tonitchek/ltm-ps/README.md

ltm-ps
======
Power Supply board based on Linear Technology uModule (LTM).

Contents
========
circuit_board :containing the design of the PCB.
simu          :simulation of the design based on LTSpiceIV
