tonitchek/ltm-ps/circuit_board/bom_ltm-ps.ods

Id | Designator | Package | Quantity | Designation | Supplier | Ref | Price | Board price | Comments
1 | U2 | BGA70-linear_standard | 1 | LTM8050 | RS | 851-4598 (http://fr.rs-online.com/web/p/convertisseurs-buck/8514598/) | 27.29 | 27.29
 | J2 | RJ45_8N | 1 | RJHSE-5080 | FARNELL | 1860577 (http://fr.farnell.com/amphenol-commercial-products/rjhse-5080/fiche-rj45-1port/dp/1860577) | 0.61 | 0.61 |  | Ok
3 | J1 | RJ45_GIGABIT-MAGJACK | 1 | 0826-1X1T-M1-F | DIGIKEY | 380-1122-ND (http://www.digikey.fr/product-detail/fr/0826-1X1T-M1-F/380-1122-ND/1635090) | 4.65 | 4.65 |  | Ok
4 | D3,D2 | SDIP04 | 2 | DF01S | RS | 670-8804 (http://fr.rs-online.com/web/p/ponts-redresseurs/6708804/) | 0.335 | 0.67
5 | C1 | C_2220 | 1 | 4.7u | FARNELL | 2435503 (http://fr.farnell.com/tdk/cga9n2x7r2a475k230ka/condensateur-mlcc-x7r-4-7uf-100v/dp/2435503) | 1.94 | 1.94 |  | Ok
6 | C2 | C_1210 | 1 | 100u | FARNELL | 1108328 (http://fr.farnell.com/kemet/c1210c107m9pactu/condensateur-mlcc-x5r-100uf-6/dp/1108328) | 0.915 | 0.915 |  | Ok
7 | C3 | C_0805 | 1 | 1000p | FARNELL | 1855318 (http://fr.farnell.com/kemet/c0805x102kdractu/condensateur-mlcc-x7r-1nf-1kv/dp/1855318) | 0.322 | 0.322 |  | Ok
8 | D1 | Diode-SMC_Standard | 1 | S5BC-13-F | FARNELL | 1858674 (http://fr.farnell.com/diodes-inc/s5bc-13-f/diode-de-redressement-gpp-100v/dp/1858674) | 0.614 | 0.614 |  | Ok
9 | D4 | Diode-SMA_Standard | 1 | SMAJ58CA | FARNELL | 1749359 (http://fr.farnell.com/stmicroelectronics/smaj58ca-tr/transil-400w-58v-bidirect-sma/dp/1749359) | 0.302 | 0.302 |  | Ok
10 | JP1 | Pin_Header_Straight_1x03 | 1 | JUMPER3 | FARNELL | 1022255 (http://fr.farnell.com/harwin/m20-9990646/embase-1-rangee-6-voies/dp/1022255) | 0.138 | 0.138 |  | Ok
11 | P1,P2,P3 | Pin_Header_Straight_1x02 | 3 | CONN_01X02 |  |  |  | 0 |  | Ok
12 | R1 | R_0805 | 1 | 93.1k | RS | 708-6720 (http://fr.rs-online.com/web/p/resistances-cms/7086720/) | 0.028 | 0.028
13 | R2 | R_0805 | 1 | 90.9k | FARNELL | 2141897 (http://fr.farnell.com/multicomp/mc01w0805190k9/resistance-90k9-0-1w-1-0805/dp/2141897) | 0.045 | 0.045 |  | Ok
14 | R3 | R_0805 | 1 | 24.9k | FARNELL | 2141867 (http://fr.farnell.com/multicomp/mc01w0805124k9/resistance-24k9-0-1w-1-0805/dp/2141867) | 0.043 | 0.043 |  | Ok
15 | R4 | R_0805 | 1 | 4.42k | FARNELL | 2141825 (http://fr.farnell.com/multicomp/mc01w080514k42/resistance-4k42-0-1w-1-0805/dp/2141825) | 0.045 | 0.045 |  | Ok
16 | R5 | R_0805 | 1 | 178k | FARNELL | 2141911 (http://fr.farnell.com/multicomp/mc01w08051178k/resistance-178k-0-1w-1-0805/dp/2141911) | 0.042 | 0.042 |  | Ok
17 | R6 | R_0805 | 1 | 150k | FARNELL | 2332100 (http://fr.farnell.com/te-connectivity/crgh0805f150k/resistance-puissance-150k-0-33w/dp/2332100) | 0.0236 | 0.0236 |  | Ok
18 | R7 | R_0805 | 1 | 100k | FARNELL | 2333538 (http://fr.farnell.com/bourns/cr0805-fx-1003elf/resistance-couche-epaisse-100k/dp/2333538) | 0.0426 | 0.0426 |  | Ok
19 | R8,R9,R10,R11 | R_0805 | 4 | 75R | FARNELL | 2332056 (http://fr.farnell.com/te-connectivity/crgh0805f75r/resistance-puissance-75r-0-33w/dp/2332056) | 0.0229 | 0.0916 |  | Ok
20 | U1 | SOIC-8-N | 1 | NCP1092 | DIGIKEY | NCP1092DGOS-ND (http://www.digikey.fr/product-detail/fr/NCP1092DG/NCP1092DGOS-ND/2442748) | 1.66 | 1.66 | Alternative to NCP1092: TI TPS2378 farnell 2144277 (http://fr.farnell.com/texas-instruments/tps2378dda/poe-ieee802-3at-type2-0-85a-8soic/dp/2144277)
 |  |  |  |  |  |  |  | 39.4718
