tonitchek/ltm-ps/circuit_board/manufacturing_outputs/ltm-ps.pdf

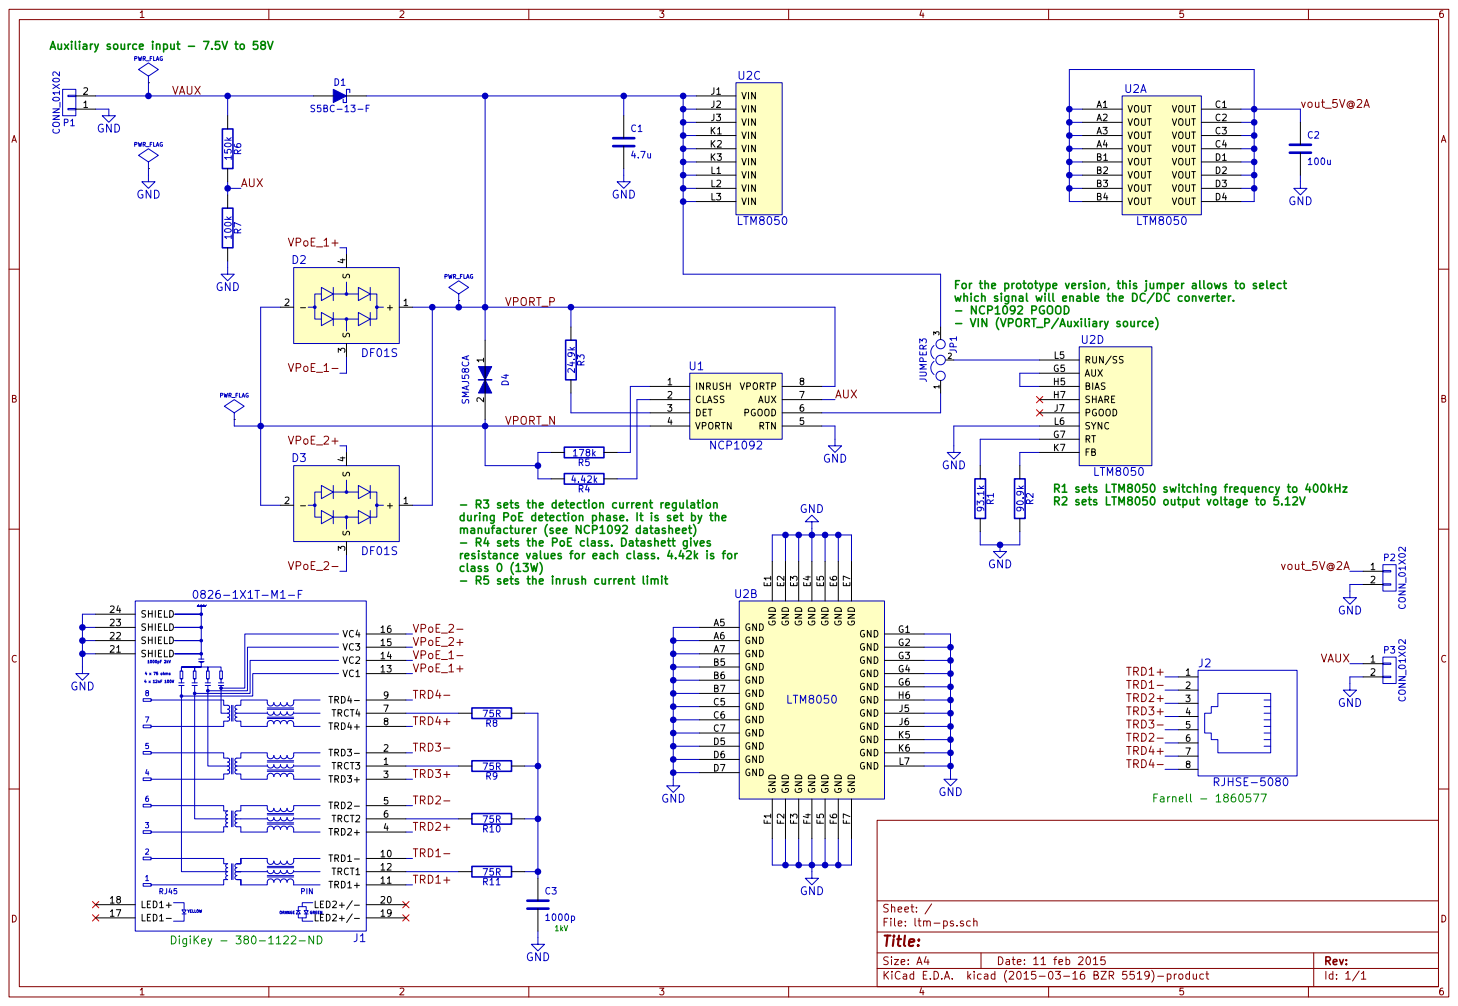
[picture p1: page 1]

PWR_FLAG Auxiliary source input - 7.5V to 58V

- R5 sets the inrush current limit VAUX

For the prototype version, this jumper allows to select
which signal will enable the DC/DC converter.
- NCP1092 PGOOD
- VIN (VPORT_P/Auxiliary source)

R1 sets LTM8050 switching frequency to 400kHz
R2 sets LTM8050 output voltage to 5.12V

- R3 sets the detection current regulation
during PoE detection phase. It is set by the
manufacturer (see NCP1092 datasheet)
- R4 sets the PoE class. Datashett gives
resistance values for each class. 4.42k is for class 0 (13W)

8 J2 RJHSE-5080 Farnell - 1860577 DigiKey - 380-1122-ND
