tonitchek/ltm-ps/simu/ltm8050-ps.asc

C1: cap; 100µ; V=6.3
C2: cap; 4.7µ; V=100
R1: res; 90.9k
R2: res; 2.5
R3: res; 93.1k
U1: LTM8050
V1: voltage; 48
Named nets: 0, VIN, VOUT
.tran 0.6m
