tonitchek/ltm-ps/simu/poe-to-vout.asc

C1: cap; 100µ; V=6.3
C2: cap; 4.7µ; V=100
D1: schottky; MBRS1100
D2: schottky; MBRS1100
D3: schottky; MBRS1100
D4: schottky; MBRS1100
R1: res; 2.5
R2: res; 89.4k
R3: res; 93.1k
U1: LTM8050
V1: voltage; SINE(0 48 1k)
Named nets: 0, Vpoe, Vout, VPORTN
.tran 1m
