tonitchek/ltm-ps/simu/auxiliary_source.asc

D1: schottky; PDS5100
R1: res; 150k
R2: res; 100k
Rload: res; 12
V1: voltage; 60
V2: voltage; 48
Named nets: 0, VPoE, VPORTP, VAUX, AUX
.tran 1m
