tonitchek/ltm-ps/simu/ltm4609-ps.asc

C1: cap; {Cb}; x{nb}; Rser={Rb} Lser={Lb} ppPkg={nb}
C2: cap; .002µ
C3: cap; {Cinb}; x{ninb}; Rser={Rinb} Lser={Linb} ppPkg={ninb}
C4: cap; {Cince}; x{nince}; Rser={Rince} Lser={Lince} ppPkg={nince}
C6: cap; {Cce}; x{nce}; Rser={Rce} Lser={Lce} ppPkg={nce}
L1: ind; {L}; Rser={DCR}
L2: ind; {Lin}; Rser={DCRin}
L3: ind; {Lout}; Rser={DCRo}
R1: res; {Rsense}
R2: res; {Rref}
R3: res; 100K
R5: res; 1.2Meg
R6: res; 4k
R7: res; 1k
U1: LTM4609
V1: voltage; {Vin}
Named nets: 0, IN, OUT, Vsw2, Vsw1
Parameters imported from LTPowerCAD Design Tool:
.tran 3.5m startup
If simulation model is not found, please "Sync Release".
.params Vin=36V Io=4A Rref=3.42K 
.params Cinb=150u Rinb=72m Linb=3.3n ninb=1 Lin=100p DCRin=0 
.params Cince=10u Rince=7m Lince=1.2n nince=1 L=4.7u DCR=7m 
.params Cb=150u Rb=35m Lb=3n nb=2 Lout=100p DCRo=0 
.params Cce=10u Rce=5m Lce=1.5n nce=2 Rsense=7.5m
