tonitchek/ltm-ps/circuit_board/ltm-ps.kicad_pcb

## KiCad design circuit_board/ltm-ps.kicad_pcb (2015-03-23)

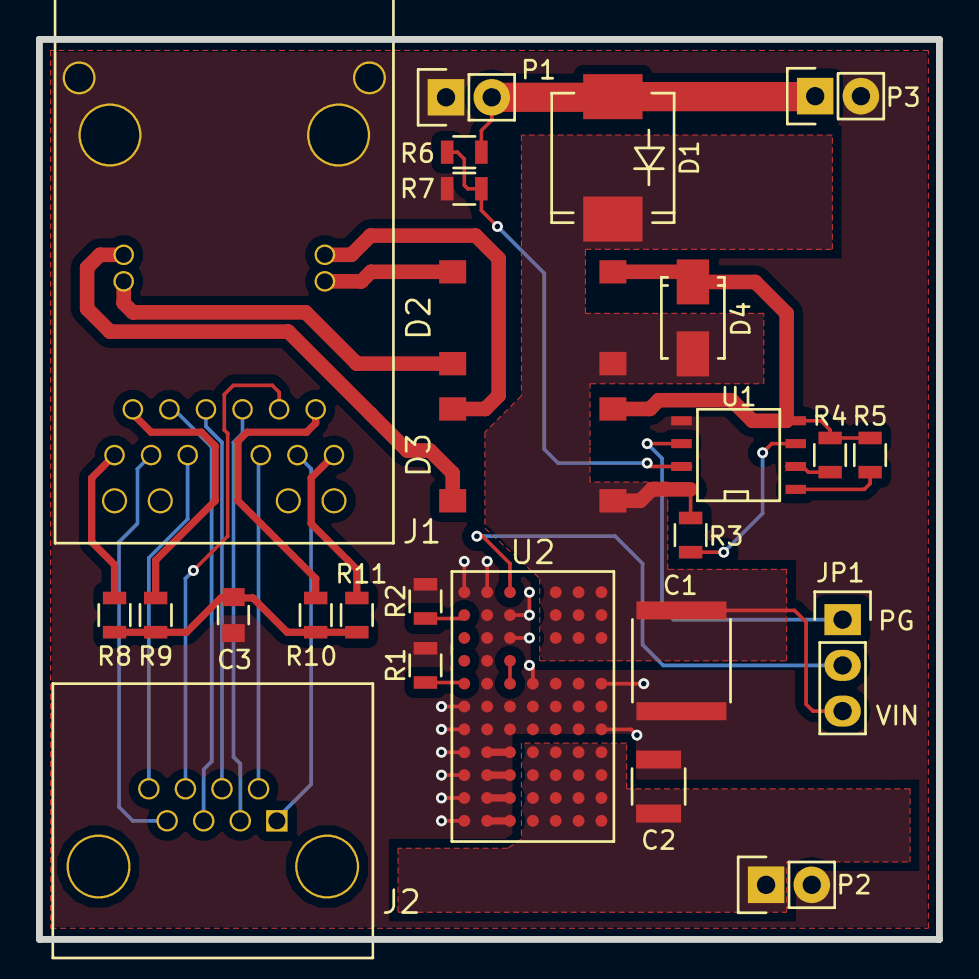
[picture p2: board ltm-ps.kicad_pcb from above]

Board: 2 copper layers, 50.0 x 50.0 mm, 26 parts (0 on the bottom side), 31 nets.

Parts:
C1: 4.7u; C_2220
C2: 100u; C_1210
C3: 1000p; C_0805
D1: S5BC-13-F; Diode-SMC_Standard
D2, D3: DF01S; SDIP04
D4: SMAJ58CA; Diode-SMA_Standard
J1: 0826-1X1T-M1-F; RJ45_GIGABIT-MAGJACK
J2: RJHSE-5080; RJ45_8N
JP1: JUMPER3; Pin_Header_Straight_1x03
P1, P2, P3: CONN_01X02; Pin_Header_Straight_1x02
R1: 93.1k; R_0805
R2: 90.9k; R_0805
R3: 24.9k; R_0805
R4: 4.42k; R_0805
R5: 178k; R_0805
R6: 150k; R_0805
R7: 100k; R_0805
R8, R9, R10, R11: 75R; R_0805
U1: NCP1092; SOIC-8-N
U2: LTM8050; BGA70-linear_standard

Connections:
/AUX: R6.2, R7.1, U1.7
/TRD1+: J1.11, J2.1
/TRD1-: J1.10, J2.2
/TRD2+: J1.4, J2.3
/TRD2-: J1.5, J2.6
/TRD3+: J1.3, J2.4
/TRD3-: J1.2, J2.5
/TRD4+: J1.8, J2.7
/TRD4-: J1.9, J2.8
/VAUX: D1.1, P1.2, P3.1, R6.1
/VPORT_N: D2.2, D3.2, D4.2, R4.2, R5.2, U1.4
/VPORT_P: C1.1, D1.2, D2.1, D3.1, D4.1, JP1.3, R3.1, U1.8, U2.J1, U2.J2, U2.J3, U2.K1, U2.K2, U2.K3, U2.L1, U2.L2, U2.L3
/VPoE_1+: D2.4, J1.13
/VPoE_1-: D2.3, J1.14
/VPoE_2+: D3.4, J1.15
/VPoE_2-: D3.3, J1.16
/vout_5V@2A: C2.1, P2.1, U2.A1, U2.A2, U2.A3, U2.A4, U2.B1, U2.B2, U2.B3, U2.B4, U2.C1, U2.C2, U2.C3, U2.C4, U2.D1, U2.D2, U2.D3, U2.D4
GND: C1.2, C2.2, C3.2, J1.21, J1.22, J1.23, J1.24, P1.1, P2.2, P3.2, R1.2, R2.2, R7.2, U1.5, U2.A5, U2.A6, U2.A7, U2.B5, U2.B6, U2.B7, U2.C5, U2.C6, U2.C7, U2.D5, U2.D6, U2.D7, U2.E1, U2.E2, U2.E3, U2.E4, U2.E5, U2.E6, U2.E7, U2.F1, U2.F2, U2.F3, U2.F4, U2.F5, U2.F6, U2.F7, U2.G1, U2.G2, U2.G3, U2.G4, U2.G6, U2.H6, U2.J5, U2.J6, U2.K5, U2.K6, U2.L6, U2.L7
unnamed: C3.1, R8.1, R9.1, R10.1, R11.1
unnamed: J1.1, R9.2
unnamed: J1.6, R10.2
unnamed: J1.7, R8.2
unnamed: J1.12, R11.2
unnamed: JP1.1, U1.6
unnamed: JP1.2, U2.L5
unnamed: R1.1, U2.G7
unnamed: R2.1, U2.K7
unnamed: R3.2, U1.3
unnamed: R4.1, U1.2
unnamed: R5.1, U1.1
unnamed: U2.G5, U2.H5
