tonitchek/ltm-ps/circuit_board/manufacturing_outputs/readme

=====================
Manufacturing outputs
=====================

These files are the GERBER outputs files generated by KiCAD.

ltmps        :contains links to the GERBER files with the names as asked by the
              manufacturer "seeedstudio"

zip-ltmps.sh :script zipping the folder ltmps for uploading in seeedstudio
              order process.
              Execute this script each time PCB is ploted from KiCAD.
