tonitchek/ltm-ps/simu/ltm4609-ps_simu-results.odt

LTM4609. Wide Input range (9-36V) with VOUT 24V @ 4A max

This document presents results of simulation on LTM4609. The following graphs shows the behavior of the component at 2 different load for each 3 different input voltage:

VIN=9V Iout=20uA

VIN=9V Iout=4A

VIN=12V Iout=20uA

VIN=12V Iout=4A

VIN=36V Iout=20uA

VIN=36V Iout=4A

Output voltage is always 24V.

Here is the schematic of the corresponding simulation around the LTM4609.

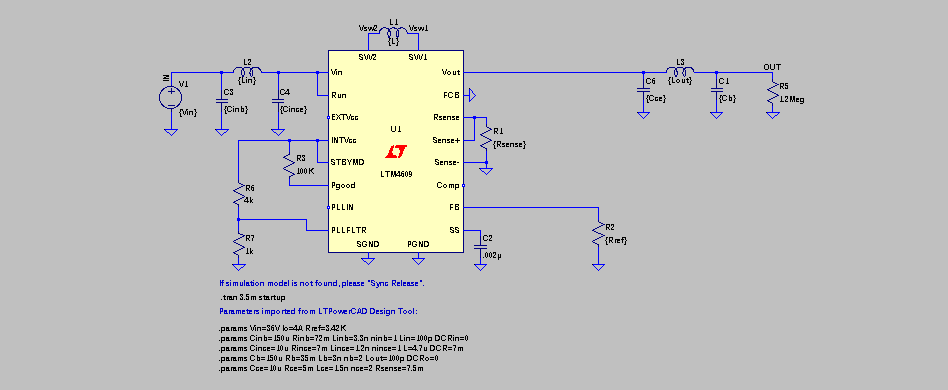
[picture p3: figure]

VIN=9V, VOUT=24V, IOUT=20uA

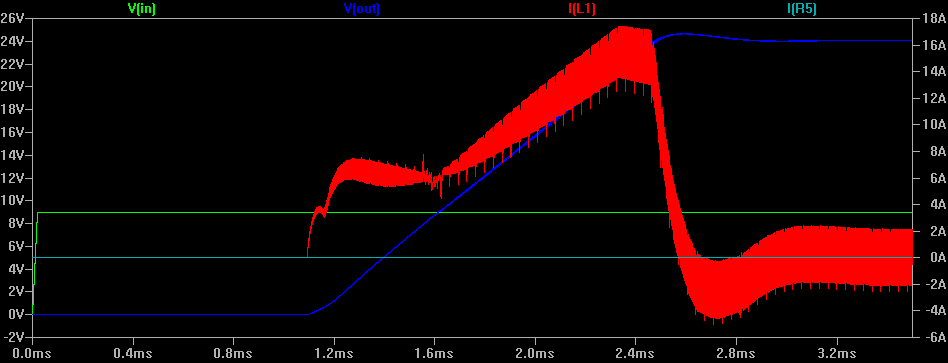
[picture p4: figure]
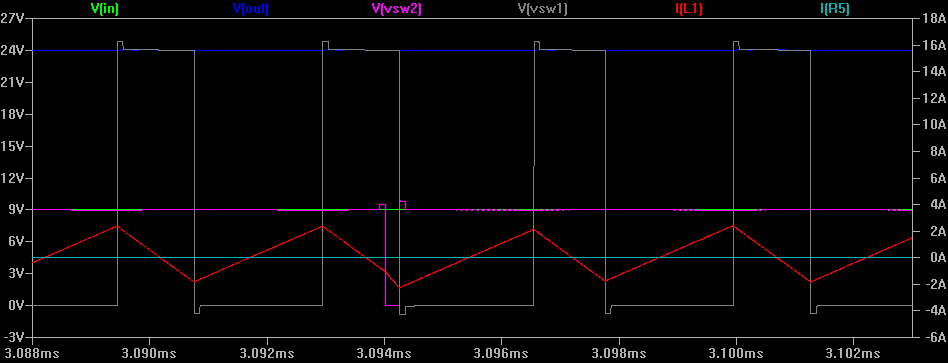
[picture p5: figure]
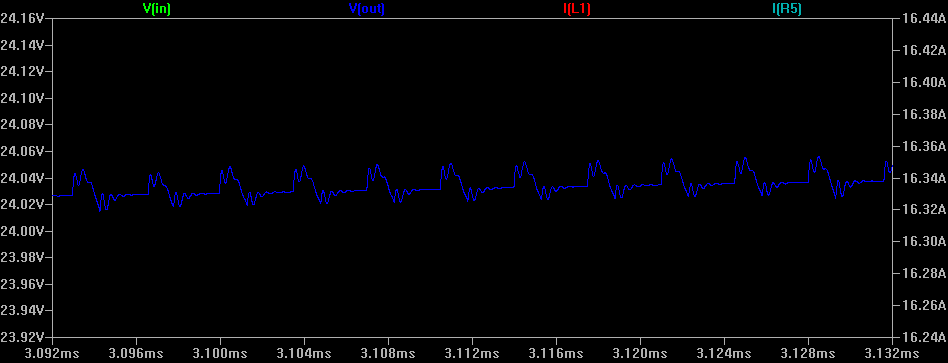
[picture p6: figure]

VIN=9V, VOUT=24V, IOUT=4A

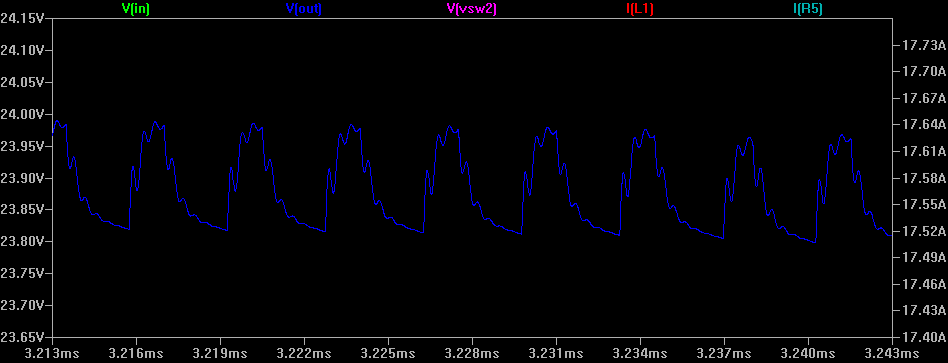
[picture p7: figure]
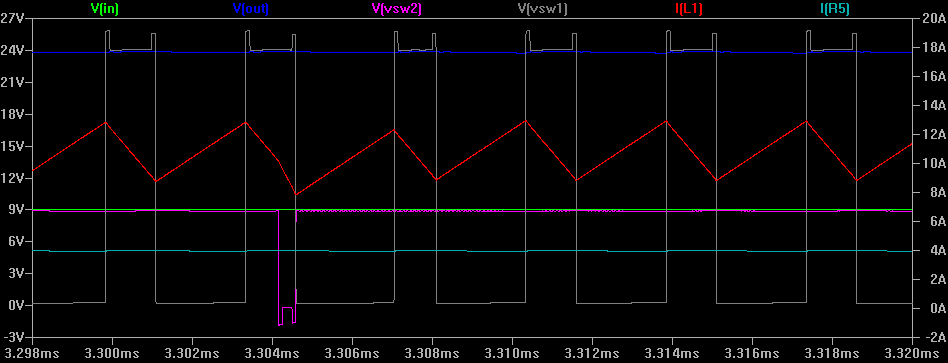
[picture p8: figure]
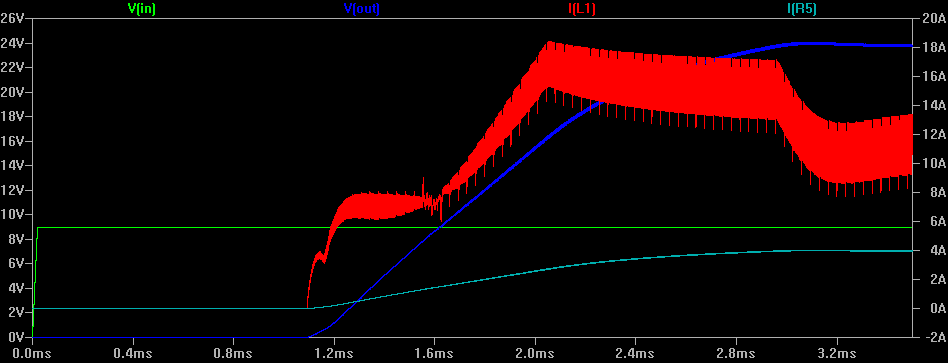
[picture p9: figure]

VIN=12V, VOUT=24V, IOUT=20uA

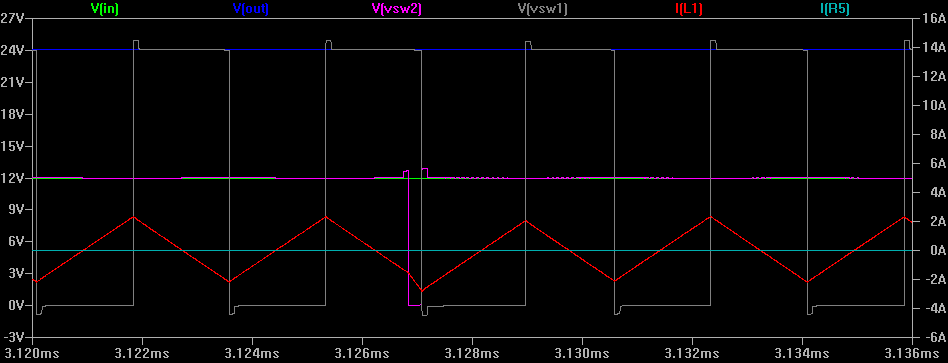
[picture p10: figure]
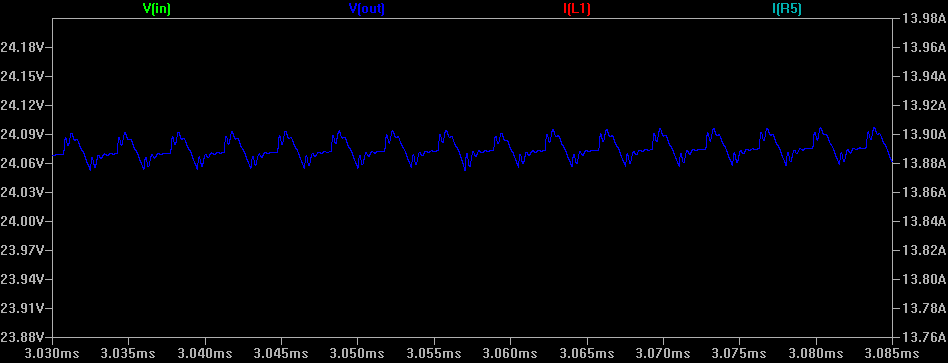
[picture p11: figure]
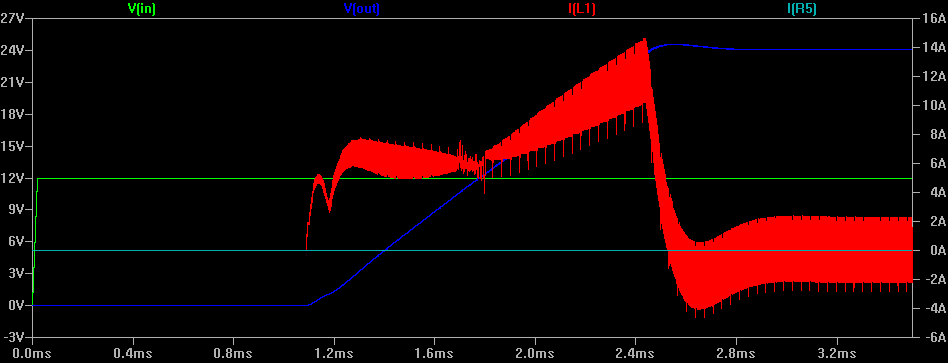
[picture p12: figure]

VIN=12V, VOUT=24V, IOUT=4A

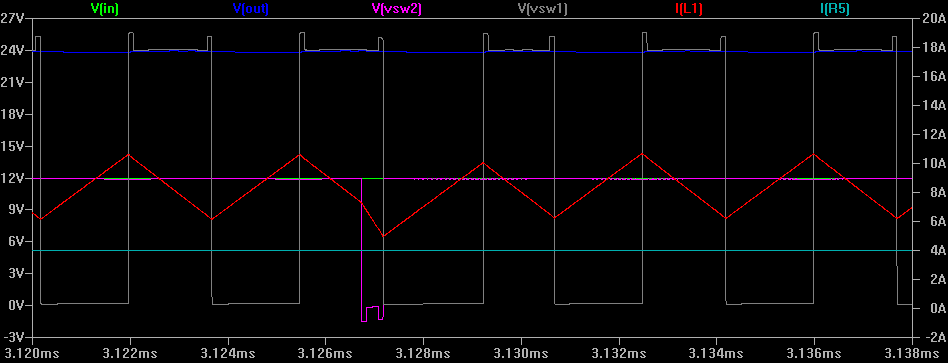
[picture p13: figure]
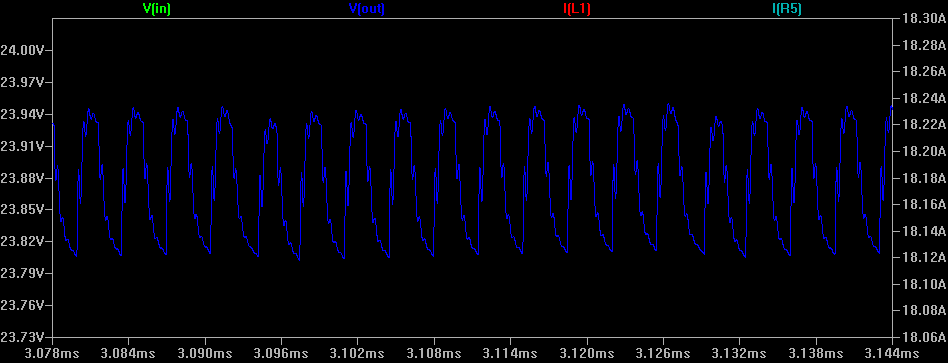
[picture p14: figure]
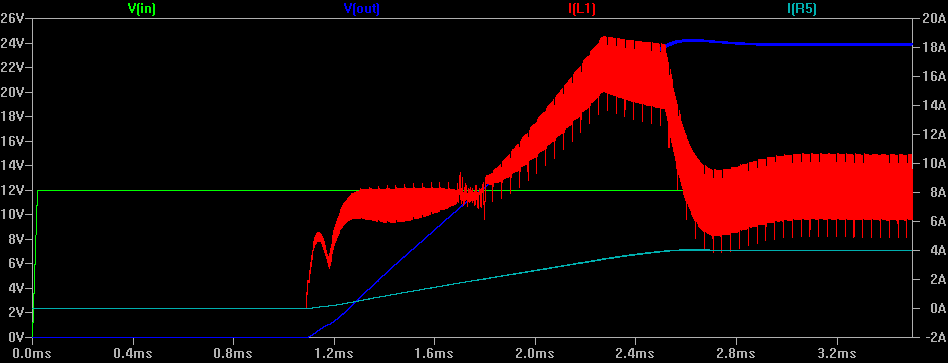
[picture p15: figure]

VIN=36V, VOUT=24V, IOUT=20uA

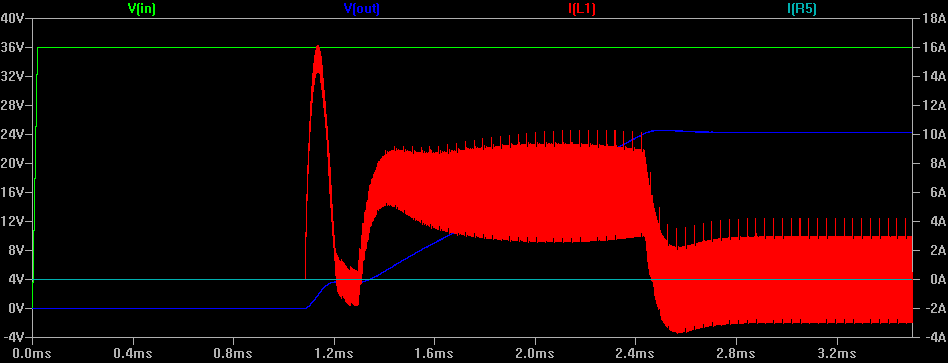
[picture p16: figure]
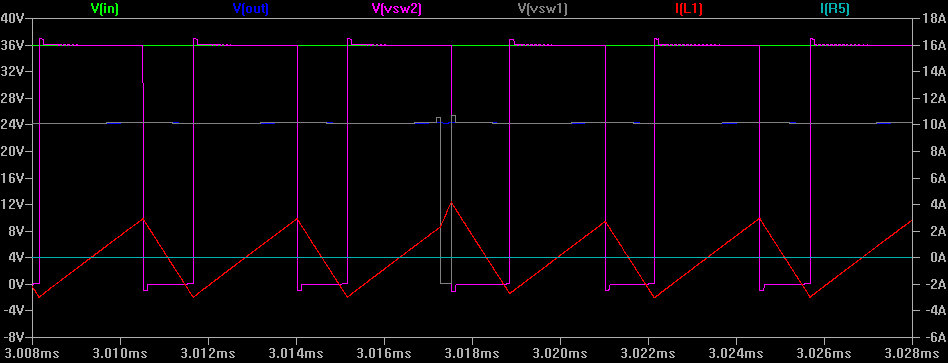
[picture p17: figure]
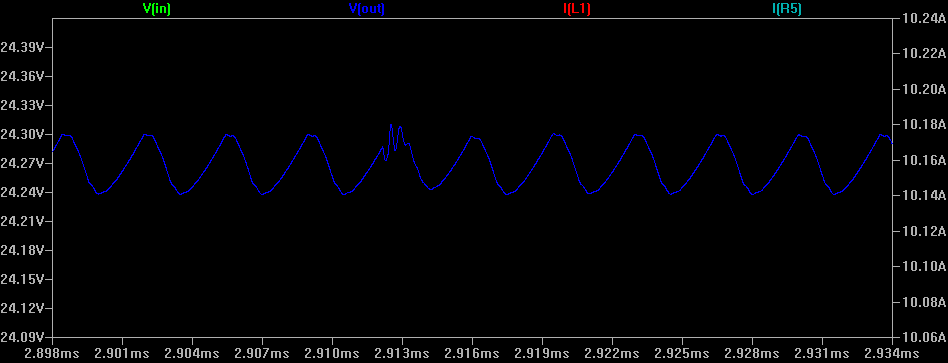
[picture p18: figure]

VIN=36V, VOUT=24V, IOUT=4A

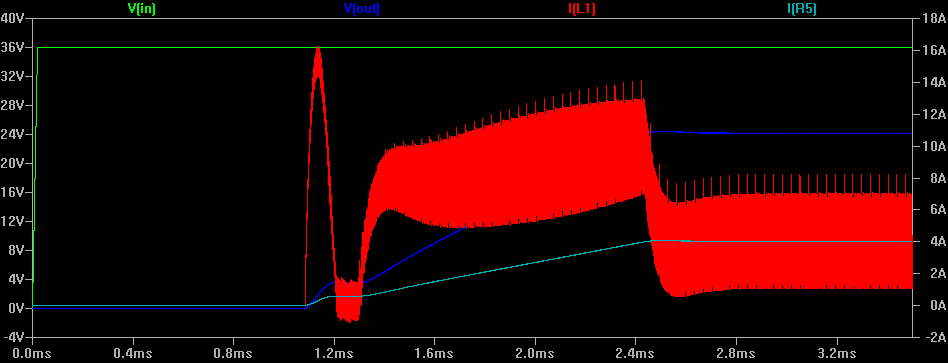
[picture p19: figure]
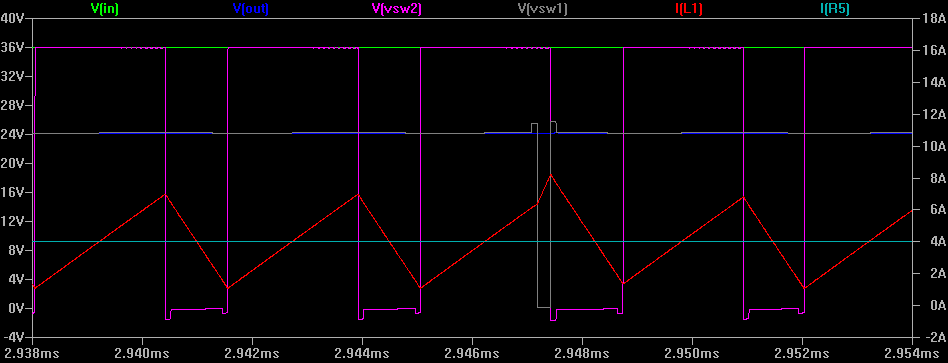
[picture p20: figure]
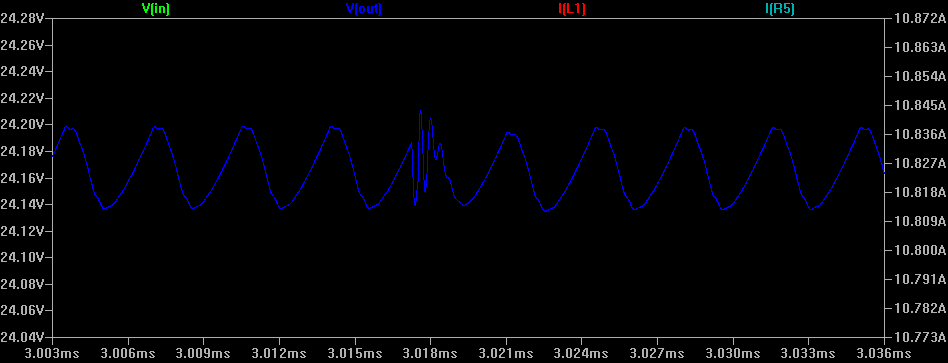
[picture p21: figure]
