tonitchek/ltm-ps/(commit log)

2015-01-19 add design and simulation files
    [ltm-ps.xls]
2015-01-21 add circuit board design. Start schematic.
    [ltm-ps.sch]
2015-01-22 modify simulation schematic
    remove optional compensation loop, change some parameters
2015-01-22 add diagram of power supply design
2015-01-27 renamed ltm-ps to ltm4609 because a simu based on another ltm will be done
    [ltm4609-ps.xls]
2015-01-28 simulate behavior of ltm8050 at maximum Vin rating voltage
2015-01-28 add simulation of auxiliary source vs PoE voltage behavior
2015-01-28 restart schamatic based on PoE feature with LTM8050 step-down converter
    [ltm-ps.sch]
2015-01-29 add PoE front end stage simulation
2015-01-29 add main IC in library and schematics
    [ltm-ps.sch]
2015-02-02 add LTM800 and NCP1092 ICs settings components. Miss RJ45 with magnetics connector
    [ltm-ps.sch]
2015-02-02 tie ltm8050 sync pin to ground and refactor ncp1092 to diode rectifiers cabling
    [ltm-ps.sch]
2015-02-02 add schematic comments and wire jumper
    [ltm-ps.sch]
2015-02-02 check ERC rules
    [ltm-ps.sch]
2015-02-02 add ncp1092 resistors settings comments
    [ltm-ps.sch]
2015-02-03 add RJ45 PoE component in schematic
    [ltm-ps.sch]
2015-02-04 add RJ45 out connector and some comments
    [ltm-ps.sch]
2015-02-04 perform ERC check on schematic
    [ltm-ps.sch]
2015-02-04 create component to footprint association
    [ltm-ps.sch]
2015-02-04 add pcbnew libraries in project files
2015-02-10 create schematic netlist, component to footprint association and BOM
    [ltm-ps.sch]
2015-02-11 replace RJ45 output component and change some footprints association
    [ltm-ps.sch]
2015-02-11 update footprint association of DF01S component
2015-02-11 add pcb design. Component/Footprint imported from netlist
    [ltm-ps.brd]
2015-02-18 start to place component in pcb
2015-02-18 change feedback resistor value to fit value available in components providers
2015-02-19 placing ltm8050 and diode rectifiers
    [ltm-ps.brd]
2015-03-13 routed all tracks. Miss gnd plane and check
    [ltm-ps.brd]
2015-03-23 review design: correct inverting RJ45 signals. Modify ltm feedback resistor from 89.4k to 90.9k. Add silkscreen text for jumper
    [ltm-ps.csv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]
2015-03-23 add BOM file
    [bom_ltm-ps.ods]
2015-04-10 update BOM due to providers components availibilities
    [bom_ltm-ps.ods]
